KoNaR-Hefajstos/MMS3_hat_GPIO_board_basic/MMS3_hat_GPIO_board_basic.kicad_pcb

## KiCad design MMS3_hat_GPIO_board_basic.kicad_pcb (2026-04-20)

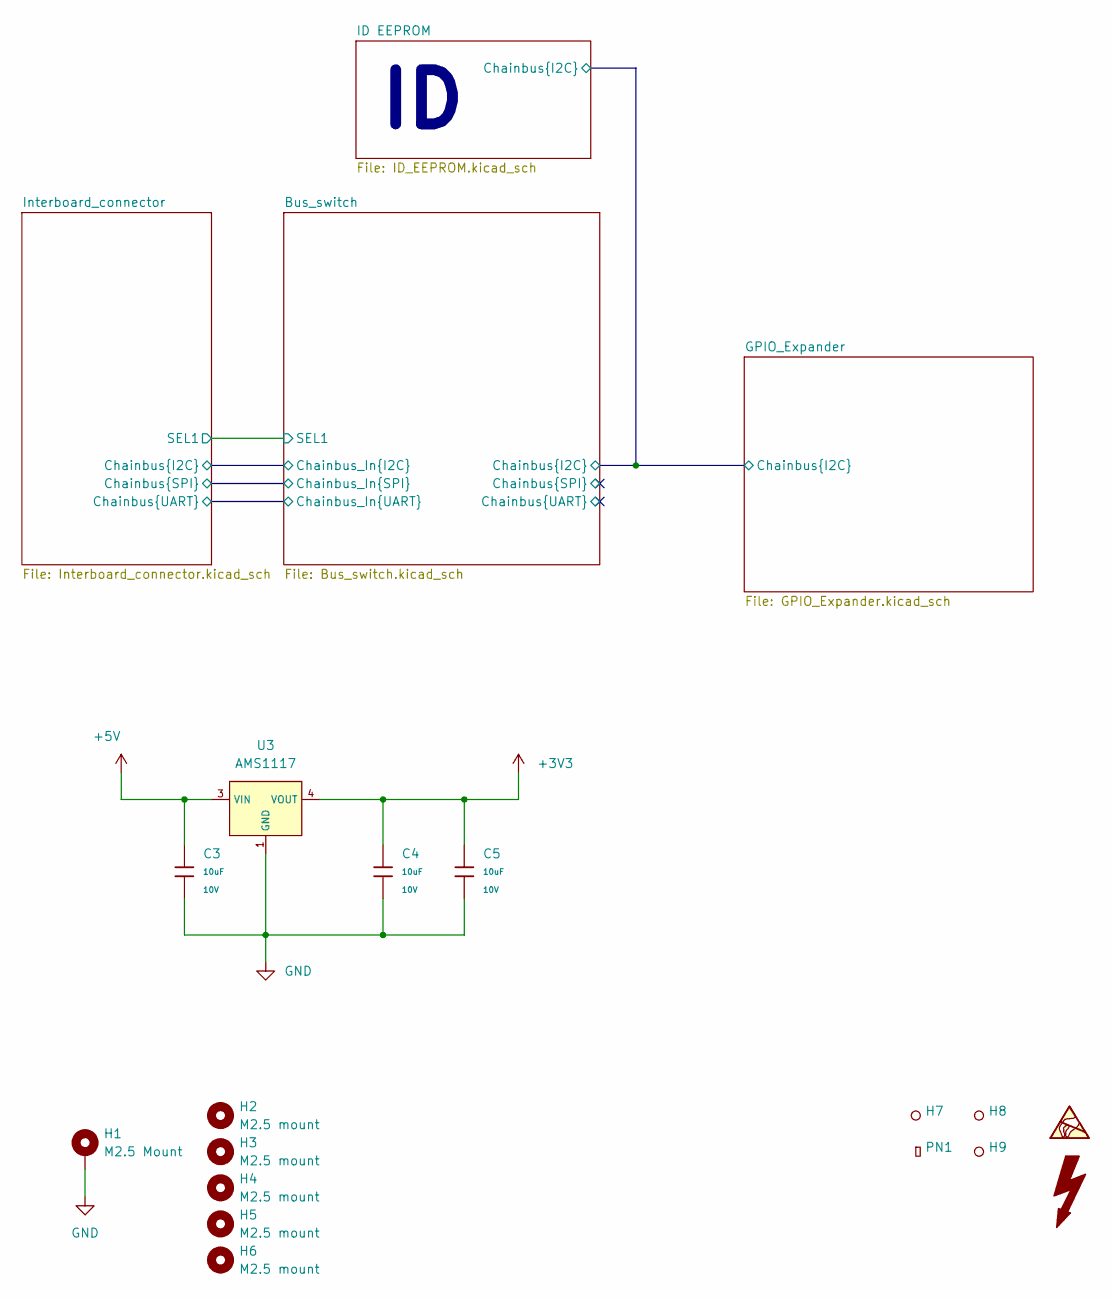
[picture p1: schematic MMS3_hat_GPIO_board_basic.kicad_sch]

Parts:
C3, C4, C5: 10uF; C_0603; Voltage Rated 10V; Tolerance ±10%; Part CL10A106KP8NNNC; LCSC C19702
H1: M2.5 Mount; MountingHole_2.7mm_M2.5_DIN965_Pad_TopOnly
H2, H3, H4, H5, H6: M2.5 mount; MountingHole_2.7mm_M2.5
H7, H8, H9: Hole_Tooling_JLCPCB
PN1: Part_Num_JLCPCB
U3: AMS1117; SOT-223-3_L6.5-W3.4-P2.30-LS7.0-BR; Output Voltage 3.3V; Dropout Voltage 1.3V@(800mA); Part AMS1117-3.3; LCSC C6186

Connections:
+3V3: C4.1, C5.1, U3.2 (VOUT), U3.4 (VOUT); also elsewhere on the board
+5V: C3.1, U3.3 (VIN); also elsewhere on the board
GND: C3.2, C4.2, C5.2, H1.1 (1_1), U3.1 (GND); also elsewhere on the board

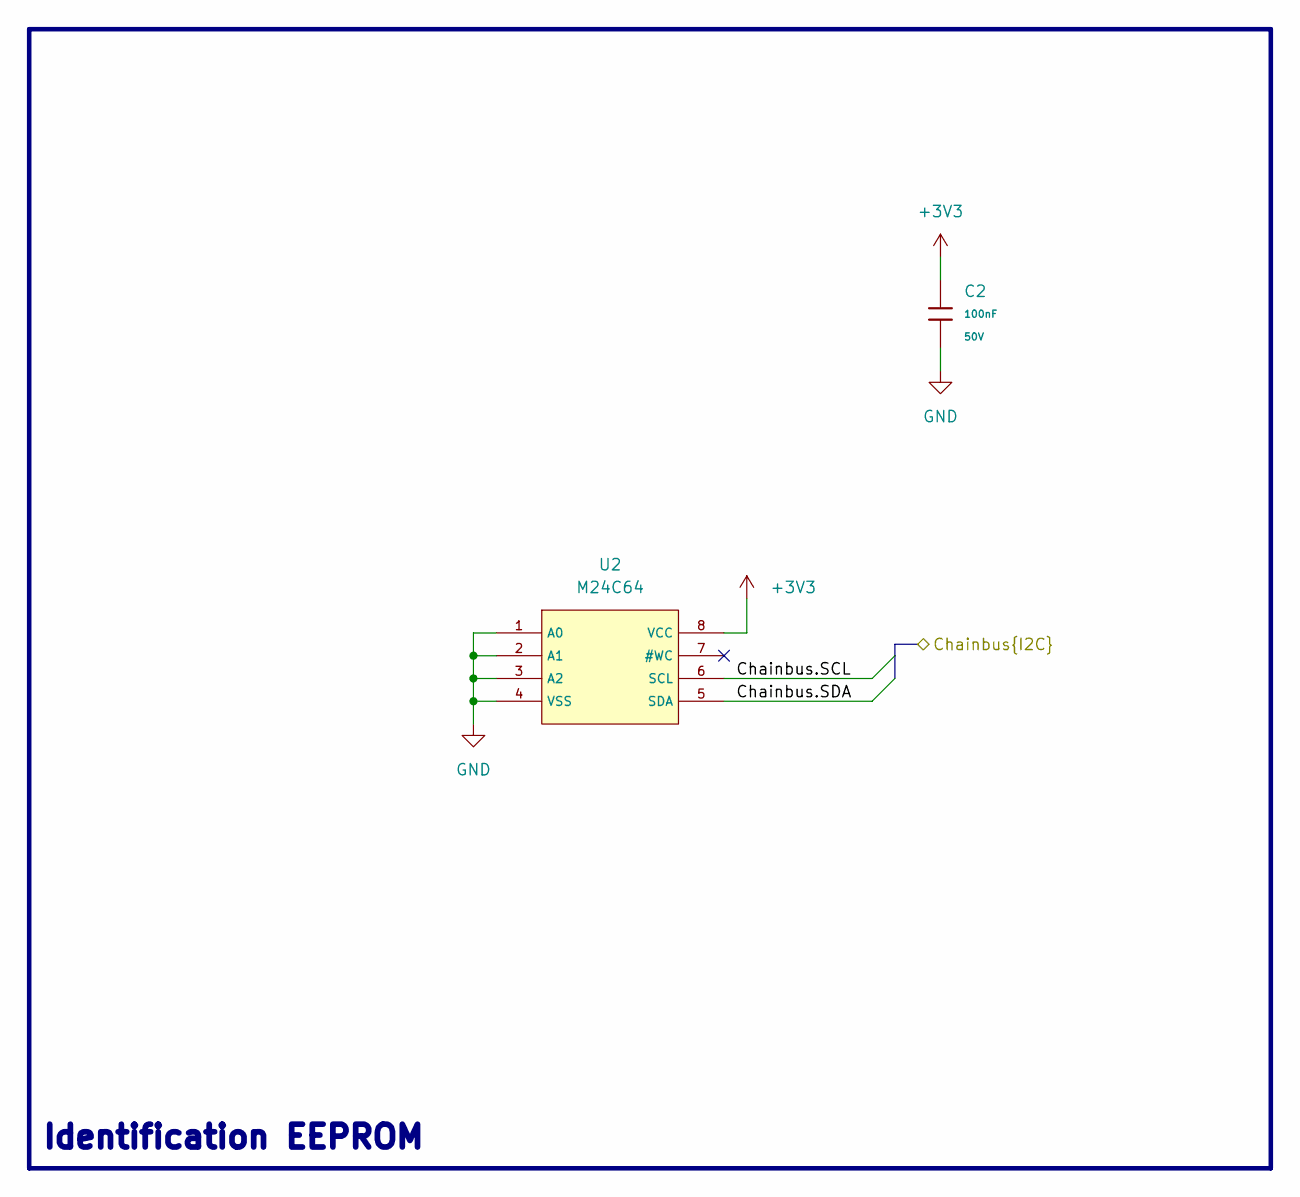
[picture p2: schematic ID_EEPROM.kicad_sch, MMS3_hat_GPIO_board_basic]

Parts:
C2: 100nF; C_0603; Voltage Rated 50V; Tolerance ±10%; Part CC0603KRX7R9BB104; LCSC C14663
U2: M24C64; SOIC-8_L5.0-W4.0-P1.27-LS6.0-BL; Supply Voltage 1.8V~5.5V; Part M24C64-RMN6TP; LCSC C79988

Connections:
+3V3: C2.1, U2.8 (VCC); also elsewhere on the board
/Bus_switch/Chainbus.SCL: U2.6 (SCL); also elsewhere on the board
/Bus_switch/Chainbus.SDA: U2.5 (SDA); also elsewhere on the board
GND: C2.2, U2.1 (A0), U2.2 (A1), U2.3 (A2), U2.4 (VSS); also elsewhere on the board

Notes on the sheet:
Identification EEPROM

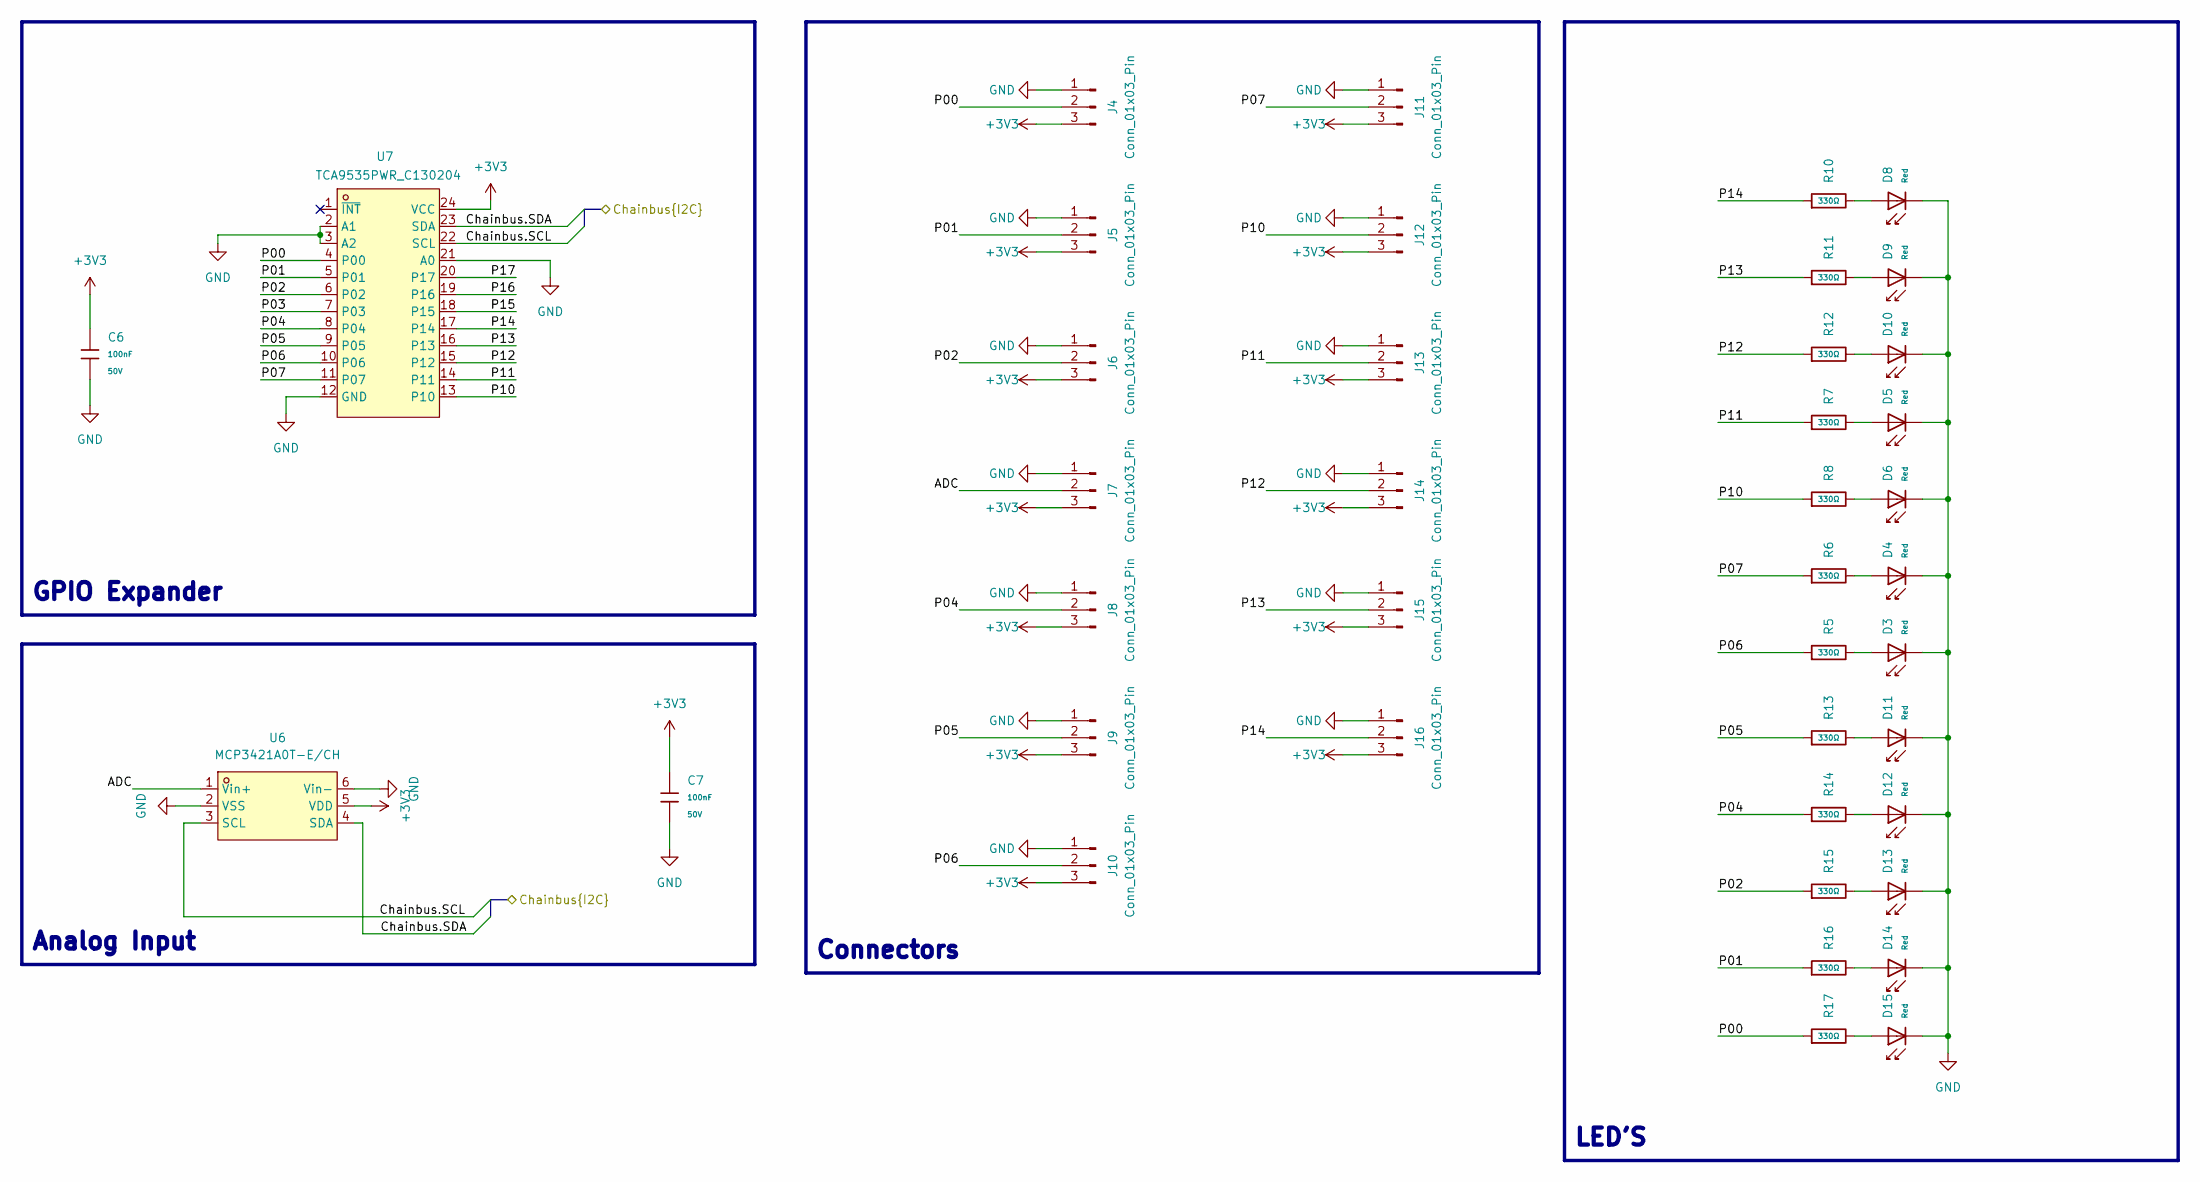
[picture p3: schematic GPIO_Expander.kicad_sch, MMS3_hat_GPIO_board_basic]

Parts:
C6, C7: 100nF; C_0603; Voltage Rated 50V; Tolerance ±10%; Part CC0603KRX7R9BB104; LCSC C14663
D3, D4, D5, D6, D8, D9, D10, D11, D12, D13, D14, D15: Red; D_0603; Part KT-0603R; LCSC C2286
J4, J5, J6, J7, J8, J9, J10, J11, J12, J13, J14, J15, J16: Conn_01x03_Pin; JST_XH_S3B-XH-A_1x03_P2.50mm_Horizontal
R5, R6, R7, R8, R10, R11, R12, R13, R14, R15, R16, R17: 330Ω; R_0402; Overload Voltage (Max) 50V; Tolerance ±1%; Part 0402WGF3300TCE; LCSC C25104
U6: MCP3421A0T-E/CH; SOT-23-6_L2.9-W1.6-P0.95-LS2.8-BR; MPN MCP3421A0T-E/CH; LCSC Part C29454
U7: TCA9535PWR_C130204; TSSOP-24_L7.8-W4.4-P0.65-LS6.4-BL; MPN TCA9535PWR; LCSC Part C130204

Connections:
+3V3: C6.1, C7.1, J4.3, J5.3, J6.3, J7.3, J8.3, J9.3, J10.3, J11.3, J12.3, J13.3, J14.3, J15.3, J16.3, U6.5 (VDD), U7.24 (VCC); also elsewhere on the board
/Bus_switch/Chainbus.SCL: U6.3 (SCL), U7.22 (SCL); also elsewhere on the board
/Bus_switch/Chainbus.SDA: U6.4 (SDA), U7.23 (SDA); also elsewhere on the board
/GPIO_Expander/ADC: J7.2, U6.1 (Vin+)
/GPIO_Expander/P00: J4.2, R17.1, U7.4 (P00)
/GPIO_Expander/P01: J5.2, R16.1, U7.5 (P01)
/GPIO_Expander/P02: J6.2, R15.1, U7.6 (P02)
/GPIO_Expander/P03: U7.7 (P03)
/GPIO_Expander/P04: J8.2, R14.1, U7.8 (P04)
/GPIO_Expander/P05: J9.2, R13.1, U7.9 (P05)
/GPIO_Expander/P06: J10.2, R5.1, U7.10 (P06)
/GPIO_Expander/P07: J11.2, R6.1, U7.11 (P07)
/GPIO_Expander/P10: J12.2, R8.1, U7.13 (P10)
/GPIO_Expander/P11: J13.2, R7.1, U7.14 (P11)
/GPIO_Expander/P12: J14.2, R12.1, U7.15 (P12)
/GPIO_Expander/P13: J15.2, R11.1, U7.16 (P13)
/GPIO_Expander/P14: J16.2, R10.1, U7.17 (P14)
/GPIO_Expander/P15: U7.18 (P15)
/GPIO_Expander/P16: U7.19 (P16)
/GPIO_Expander/P17: U7.20 (P17)
GND: C6.2, C7.2, D3.1, D4.1, D5.1, D6.1, D8.1, D9.1, D10.1, D11.1, D12.1, D13.1, D14.1, D15.1, J4.1, J5.1, J6.1, J7.1, J8.1, J9.1, J10.1, J11.1, J12.1, J13.1, J14.1, J15.1, J16.1, U6.2 (VSS), U6.6 (Vin-), U7.2 (A1), U7.3 (A2), U7.12 (GND), U7.21 (A0); also elsewhere on the board
unnamed: D3.2, R5.2
unnamed: D4.2, R6.2
unnamed: D5.2, R7.2
unnamed: D6.2, R8.2
unnamed: D8.2, R10.2
unnamed: D9.2, R11.2
unnamed: D10.2, R12.2
unnamed: D11.2, R13.2
unnamed: D12.2, R14.2
unnamed: D13.2, R15.2
unnamed: D14.2, R16.2
unnamed: D15.2, R17.2

Notes on the sheet:
GPIO Expander
LED'S
Connectors
Analog Input

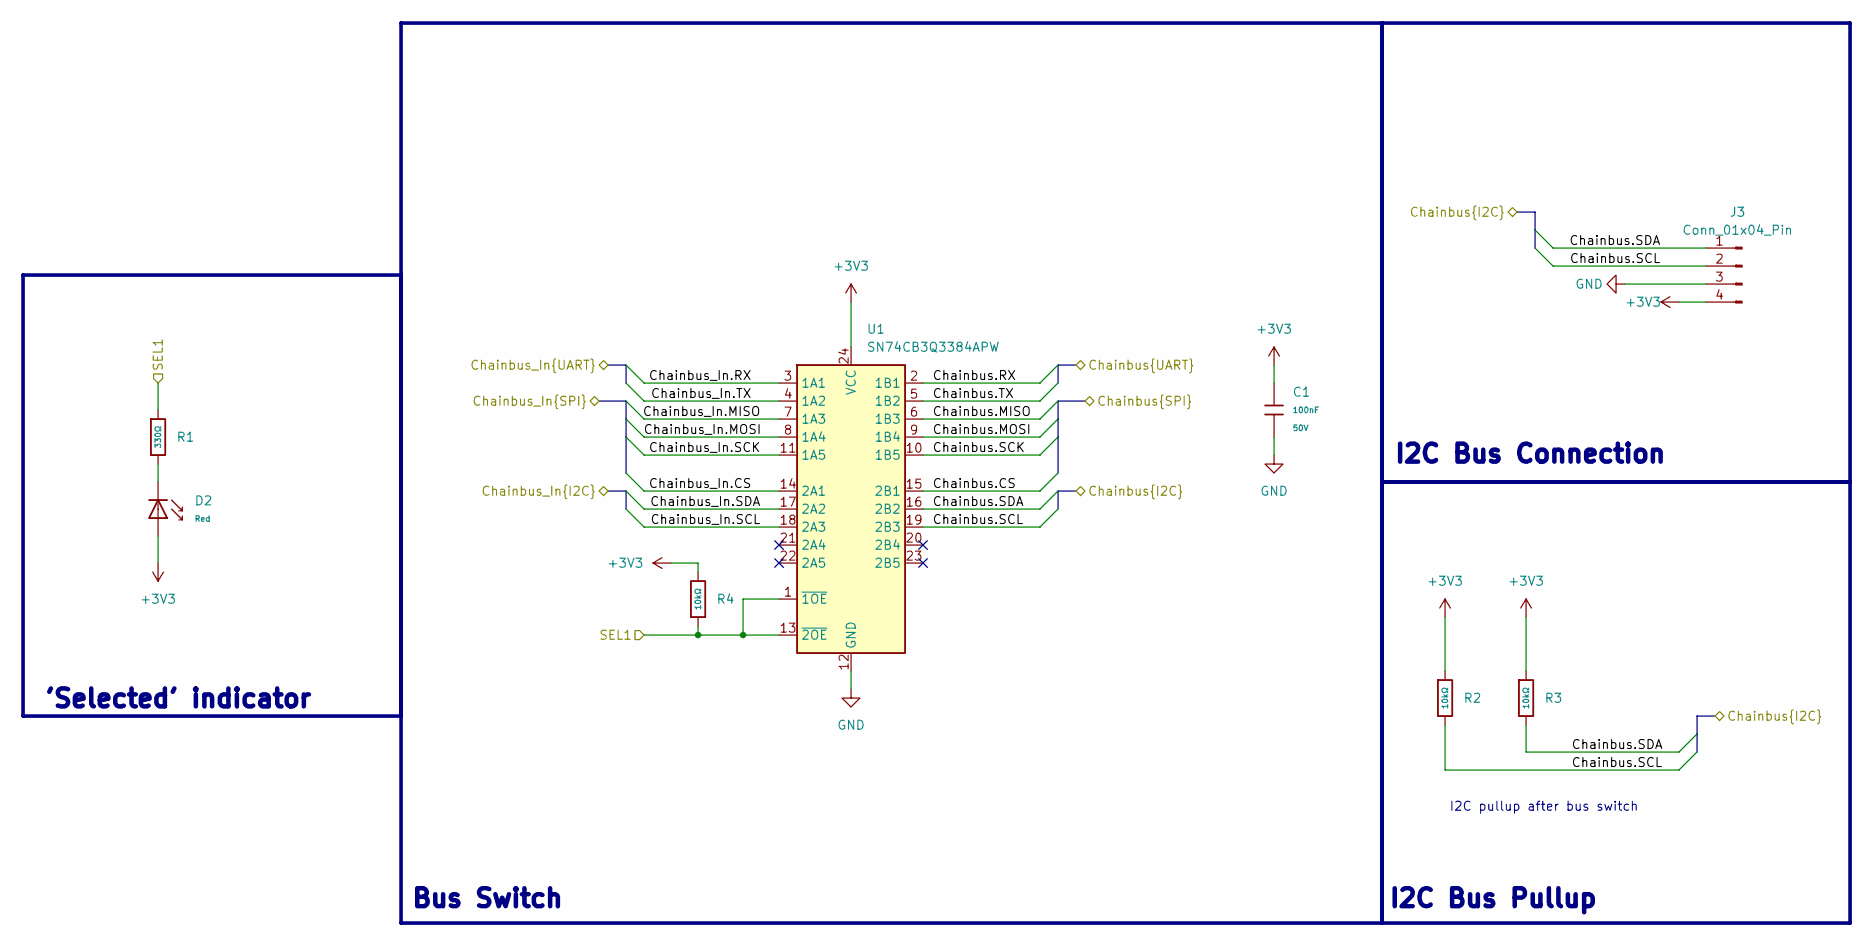
[picture p4: schematic Bus_switch.kicad_sch, MMS3_hat_GPIO_board_basic]

Parts:
C1: 100nF; C_0603; Voltage Rated 50V; Tolerance ±10%; Part CC0603KRX7R9BB104; LCSC C14663
D2: Red; D_0603; Part KT-0603R; LCSC C2286
J3: Conn_01x04_Pin; PinHeader_1x04_P2.54mm_Vertical
R1: 330Ω; R_0402; Overload Voltage (Max) 50V; Tolerance ±1%; Part 0402WGF3300TCE; LCSC C25104
R2, R3, R4: 10kΩ; R_0402; Overload Voltage (Max) 50V; Tolerance ±1%; Part 0402WGF1002TCE; LCSC C25744
U1: SN74CB3Q3384APW; TSSOP-24_4.4x7.8mm_P0.65mm; LCSC C469874

Connections:
+3V3: C1.1, D2.2, J3.4, R2.1, R3.1, R4.2, U1.24 (VCC); also elsewhere on the board
/Bus_switch/Chainbus.CS: U1.15 (2B1)
/Bus_switch/Chainbus.MISO: U1.6 (1B3)
/Bus_switch/Chainbus.MOSI: U1.9 (1B4)
/Bus_switch/Chainbus.RX: U1.2 (1B1)
/Bus_switch/Chainbus.SCK: U1.10 (1B5)
/Bus_switch/Chainbus.SCL: J3.2, R2.2, U1.19 (2B3); also elsewhere on the board
/Bus_switch/Chainbus.SDA: J3.1, R3.2, U1.16 (2B2); also elsewhere on the board
/Bus_switch/Chainbus.TX: U1.5 (1B2)
/Bus_switch/Chainbus_In.CS: U1.14 (2A1); also elsewhere on the board
/Bus_switch/Chainbus_In.MISO: U1.7 (1A3); also elsewhere on the board
/Bus_switch/Chainbus_In.MOSI: U1.8 (1A4); also elsewhere on the board
/Bus_switch/Chainbus_In.RX: U1.3 (1A1); also elsewhere on the board
/Bus_switch/Chainbus_In.SCK: U1.11 (1A5); also elsewhere on the board
/Bus_switch/Chainbus_In.SCL: U1.18 (2A3); also elsewhere on the board
/Bus_switch/Chainbus_In.SDA: U1.17 (2A2); also elsewhere on the board
/Bus_switch/Chainbus_In.TX: U1.4 (1A2); also elsewhere on the board
/Bus_switch/SEL1: R1.1, R4.1, U1.1 (~1OE), U1.13 (~2OE); also elsewhere on the board
GND: C1.2, J3.3, U1.12 (GND); also elsewhere on the board
unnamed: D2.1, R1.2

Notes on the sheet:
Bus Switch
'Selected' indicator
I2C Bus Pullup
I2C pullup after bus switch
I2C Bus Connection

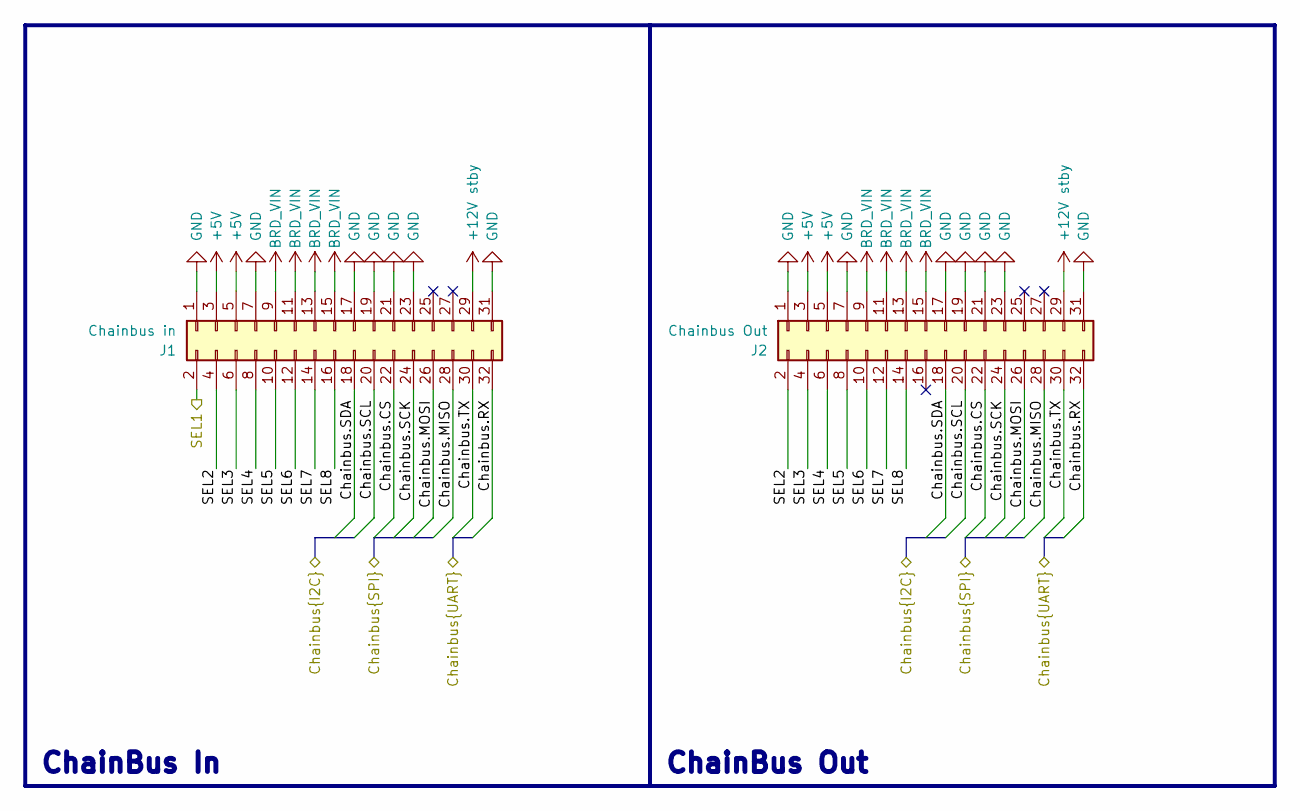
[picture p5: schematic Interboard_connector.kicad_sch, MMS3_hat_GPIO_board_basic]

Parts:
J1: Chainbus in; PinHeader_2x16_P2.54mm_Vertical_SMD
J2: Chainbus Out; PinSocket_2x16_P2.54mm_Vertical_SMD

Connections:
+5V: J1.3, J1.5, J2.3, J2.5; also elsewhere on the board
+12V stby: J1.29, J2.29
/Bus_switch/Chainbus_In.CS: J1.22, J2.22; also elsewhere on the board
/Bus_switch/Chainbus_In.MISO: J1.28, J2.28; also elsewhere on the board
/Bus_switch/Chainbus_In.MOSI: J1.26, J2.26; also elsewhere on the board
/Bus_switch/Chainbus_In.RX: J1.32, J2.32; also elsewhere on the board
/Bus_switch/Chainbus_In.SCK: J1.24, J2.24; also elsewhere on the board
/Bus_switch/Chainbus_In.SCL: J1.20, J2.20; also elsewhere on the board
/Bus_switch/Chainbus_In.SDA: J1.18, J2.18; also elsewhere on the board
/Bus_switch/Chainbus_In.TX: J1.30, J2.30; also elsewhere on the board
/Bus_switch/SEL1: J1.2; also elsewhere on the board
/Interboard_connector/SEL2: J1.4, J2.2
/Interboard_connector/SEL3: J1.6, J2.4
/Interboard_connector/SEL4: J1.8, J2.6
/Interboard_connector/SEL5: J1.10, J2.8
/Interboard_connector/SEL6: J1.12, J2.10
/Interboard_connector/SEL7: J1.14, J2.12
/Interboard_connector/SEL8: J1.16, J2.14
BRD_VIN: J1.9, J1.11, J1.13, J1.15, J2.9, J2.11, J2.13, J2.15
GND: J1.1, J1.7, J1.17, J1.19, J1.21, J1.23, J1.31, J2.1, J2.7, J2.17, J2.19, J2.21, J2.23, J2.31; also elsewhere on the board

Notes on the sheet:
ChainBus In
ChainBus Out

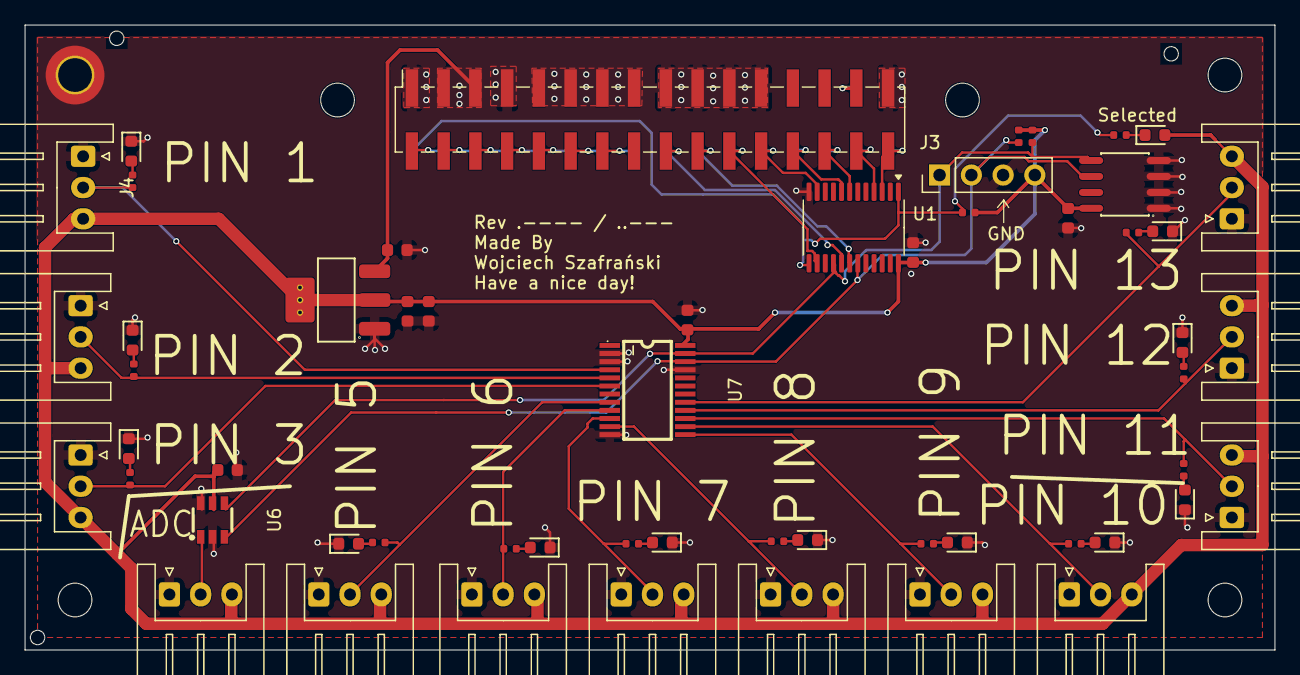
[picture p6: board MMS3_hat_GPIO_board_basic.kicad_pcb from above]

Board: 2 copper layers, 100.0 x 50.0 mm, 66 parts (1 on the bottom side), 49 nets.
