KoNaR-Hefajstos/MMS3_hat_GPIO_board_basic/(commit log)

2026-03-01 cleaned up the repo
    [Bus_switch.kicad_sch, GPIO_Expander.kicad_sch, ID_EEPROM.kicad_sch, In_Out_stage.kicad_sch, Interboard_connector.kicad_sch, MMS3_hat_GPIO_board_basic.kicad_pcb, MMS3_hat_GPIO_board_basic.kicad_sch, Power_Connector.kicad_sch]
2026-03-01 added routing and gerber
    [BOM-MMS3_hat_GPIO_board_basic.csv, GPIO_Expander.kicad_sch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]
2026-03-01 added adc
    [BOM-MMS3_hat_GPIO_board_basic.csv, GPIO_Expander.kicad_sch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]
2026-03-12 cosmetic changes
    [CPL-MMS3_hat_GPIO_board_basic.csv, MMS3_hat_GPIO_board_basic-CuBottom.gbr, MMS3_hat_GPIO_board_basic-CuTop.gbr, MMS3_hat_GPIO_board_basic-EdgeCuts.gbr, MMS3_hat_GPIO_board_basic-MaskBottom.gbr, MMS3_hat_GPIO_board_basic-MaskTop.gbr, MMS3_hat_GPIO_board_basic-NPTH.drl, MMS3_hat_GPIO_board_basic-PTH.drl]
2026-04-17 added leds and bom. Revison 1.2
    [BOM-MMS3_hat_GPIO_board_basic.csv, Bus_switch.kicad_sch, GPIO_Expander.kicad_sch, ID_EEPROM.kicad_sch, Interboard_connector.kicad_sch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]
2026-04-18 fixed selected led polarity
    [BOM-MMS3_hat_GPIO_board_basic.csv, Bus_switch.kicad_sch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]
2026-04-20 generated final gerber
    [BOM-MMS3_hat_GPIO_board_basic.csv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]
